EAH-Jena/asuromote/README.md

asuromote
=========

AsureMote - Asuro Remote Control Unit
