EAH-Jena/asuromote/doc/laborbuch/titelseite.tex

\begin{titlepage}
\vspace*{\fill}
\begin{center}
	\textsc{\LARGE Ernst-Abbe-Hochschule Jena} \\ [1.5cm]

	\textsc{\Large Projekt Mikrorechnerentwurf} \\ [0.5cm]

	\HRule \\ [0.3cm]
	{\LARGE AsuroMote}\\	[0.3cm]
	{\Large Entwicklung einer Roboterfernsteuerung }
	\HRule \\ [1 cm]

	\begin{minipage}{0.4\textwidth}
		\begin{flushleft} \large
			\emph{Gruppenmitglieder:}\\
			Stefan \textsc{Biereigel}\\
			Rene \textsc{Winkler}\\
			Mathias \textsc{Fugmann}\\
			Junlong \textsc{Yin}\\
		\end{flushleft}
	\end{minipage}
	\begin{minipage}{0.4\textwidth}
		\begin{flushright} \large
			\emph{Betreuer:}\\
			Burkart \textsc{Voß}\\
		\end{flushright}
	\end{minipage}

\end{center}
\vspace*{\fill}
\end{titlepage}
