EAH-Jena/asuromote/doc/laborbuch/treffen/treffen-2014-11-06.tex

\chapter{Treffen am 6.11.2014}
\section{Anwesende Personen}
\begin{itemize}
	\item Stefan Biereigel
	\item Rene Winkler
	\item Mathias Fugmann
	\item Junlong Yin
\end{itemize}

\section{Besprochen bzw. Bearbeitet}
Dieses Praktikum wurde vollständig für die Kodierung und Verbesserung des SPI-Moduls verwendet. Dieses wird nun für die Ansteuerung des Beschleunigungs-Sensors genutzt.

Mathias und Stefan besprachen einen sinnvollen Weg zur Versionsverwaltung von Dokumentation und Software und einigten sich auf die Verwendung von Git als Source Code Management System. Ein Treffen für eine gemeinsame Einführung in Git wurde auf den 7.11. terminiert.
