EAH-Jena/asuromote/doc/hw-spec/hw-spec.odt

asuroMote

Hardwarespezifikation (Remote Control)

Autor: Stefan Biereigel, Rene Winkler

Stand: 25.04.2015

Gültigkeit: gültig, alle Angaben aber TBC

# Aufgabe dieses Dokuments

Für die Erfüllung aller Kundenanforderungen muss eine Hardware entwickelt werden, die das STM32F4 Discovery mit den angeschlossenen Peripheriebaugruppen verbindet. Auch ein zu erarbeitendes Stromversorgungskonzept muss auf dieser Hardware umgesetzt werden. Dieses Dokument beschreibt alle Hardware-Schnittstellen und die Implementierung aller Features.

# Anforderungen

An die Hardware werden folgende Anforderungen (in loser Folge) gestellt:

- STM32F4 Discovery als Grundlage zur Anbindung von Peripherie
- Anbindung des LC-Displays, Positionierung nach Fertigungszeichnung
- Anbindung des nRF24L01
- Anbindung von 4 Tastern, Positionierung nach Fertigungszeichnung
- Anbindung von einem Joystick, Positionierung nach Fertigungszeichnung
- Anbindung eines 3-Wege-Schiebeschalters nach Fertigungszeichnung
- Anbindung eines Li-Ion/Li-Po-Akkus inklusive Ladeschaltung
  - Bereitstellen des Ladestatus am STM32F4
- Signalisierung des Stromversorgungszustandes durch eine LED
- Integration eines USB-Seriell-Wandlers
- Rücksichtnahme auf Positionierung aller Bauteile
- Verwendung von Gehäusen mit Pitch >= 0,5mm

# Peripherieanbindung an STM32F4

Der STM32F407VG als CPU soll mit allen Hardwareelementen kommunizieren können. In der folgenden Tabelle sind alle anzubindenden Signale mit deren entsprechendem Pin und der optionalen Hardwarefunktionalität aufgeführt.

Funktion | Pin (STM32F407) | Alternate Function | Bemerkung
nRF24L01 CS | PB12 | SPI2_NSS
nRF24L01 CE | PB10 | GPIO | auch MP45DT02 CLK
nRF24L01 SCLK | PB13 | SPI2_SCK
nRF24L01 MOSI | PB15 | SPI2_MOSI
nRF24L01 MISO | PB14 | SPI2_MISO
nRF24L01 IRQ | PB11 | GPIO
LCD RESET | PA8 | GPIO
LCD RS | PA10 | GPIO | USB ID
LCD CS | PA15 | SPI3_NSS
LCD SCLK | PC10 | SPI3_SCK | auch CS43L22 CLK
LCD MOSI/MISO | PC12 | SPI3_MOSI | auch CS43L22 SDIN
USB-UART TX | PA1 | USART4_RX
USB-UART RX | PA0 | USART4_TX | auch USER-Button
Taster „Rechts“ | PE8 | GPIO | T1
Taster „Runter“ | PE10 | GPIO | T2
Taster „Links“ | PE12 | GPIO | T3
Taster „Hoch“ | PE14 | GPIO | T4
Joystick „X“ | PC1 | ADC123_IN11
Joystick „Y“ | PC2 | ADC123_IN12
Power-Supply-Enable | x | x | Nur zur SMPS
Accelerometer Enable | PC6 | GPIO | Vom Schalter, low active
Charging Active | PA3 | GPIO | low active

# Steckverbinder-Spezifikation

Zur Verbindung der drei Leiterplatten werden zwei Steckverbinder eingesetzt. Diese sind als 2,54mm-Raster-Stiftleisten ausgeführt. Auf dem Mainboard sind wegen anliegender Spannungen (Kurzschlussgefahr) Buchsenleisten angebracht, die Sfiftleisten auf den angeschlossenen Leiterplatten.

# | Signal | Bemerkung

1 | 3V | kommend von STM32F4 Discovery
2 | JOY_X | X-Achse Joystick, an ADC angebunden
3 | JOY_Y | Y-Achse Joystick, an ADC angebunden
4 | GND

# | Signal | Bemerkung

1 | GND
2 | ACC_EN | Low-Aktiv, Aktivierung des Beschleunigungssensors
3 | PS_SHDN | High-Aktiv, Abschaltung der Stromversorgung
4 | T1 | Taste „Rechts“
5 | T2 | Taste „Runter“
6 | T3 | Taste „Links“
7 | T4 | Taste „Hoch“
