EAH-Jena/asuromote/doc/laborbuch/anhang.tex

\chapter{Anhang}

\begin{figure}
	\centering
	
	\caption{Konzept-Übersicht}
	\label{fig:konzepte1}
\end{figure}

% Konzepte, erste Version
\begin{figure}
	\centering
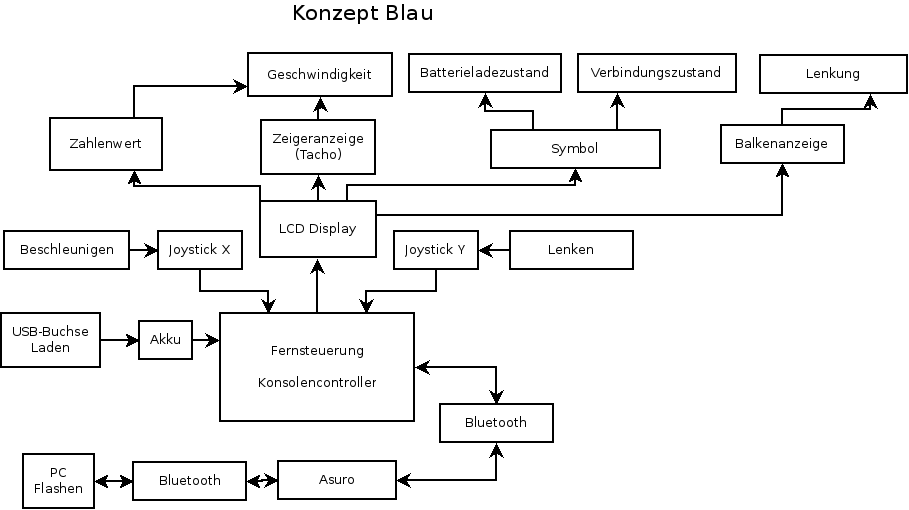
[picture p2: doc/laborbuch/konzepte_v1/Konzept_Blau.png]
	
	\label{fig:blau_v1}
	\caption{Konzept Blau, Version 1}
\end{figure}

\begin{figure}
	\centering
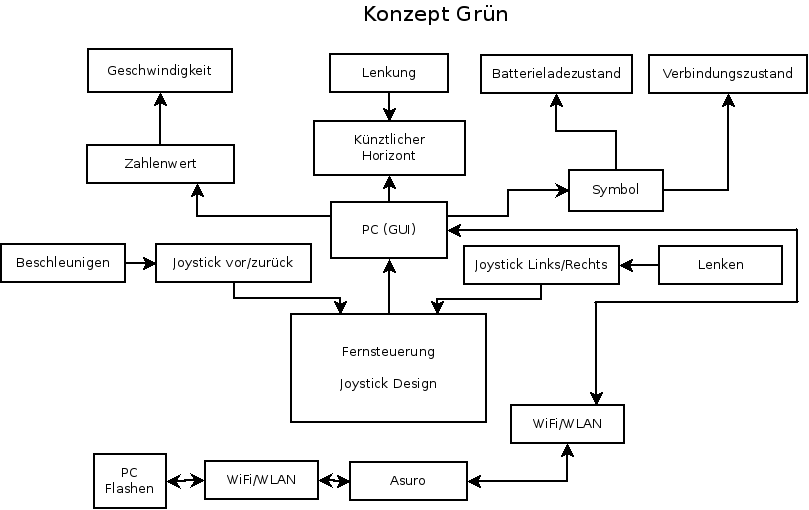
[picture p3: doc/laborbuch/konzepte_v1/Konzept_Gruen.png]
	
	\caption{Konzept Grün, Version 1}
	\label{fig:gruen_v1}
\end{figure}

\begin{figure}
	\centering
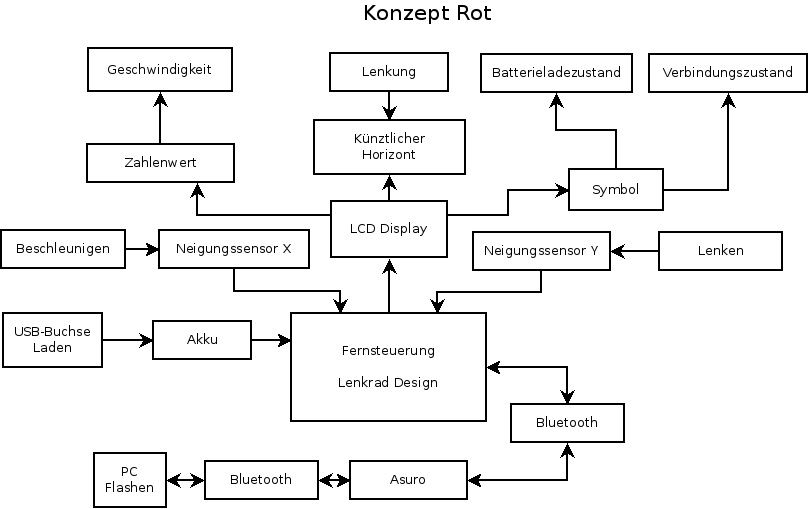
[picture p4: doc/laborbuch/konzepte_v1/Konzept_Rot.png]
	
	\caption{Konzept Rot, Version 1}
	\label{fig:rot_v1}
\end{figure}

% Konzepte, zweite Version
\begin{figure}
	\centering
	
	\caption{Konzept-Übersicht, Version 2}
	\label{fig:konzepte2}
\end{figure}

\begin{figure}
	\centering
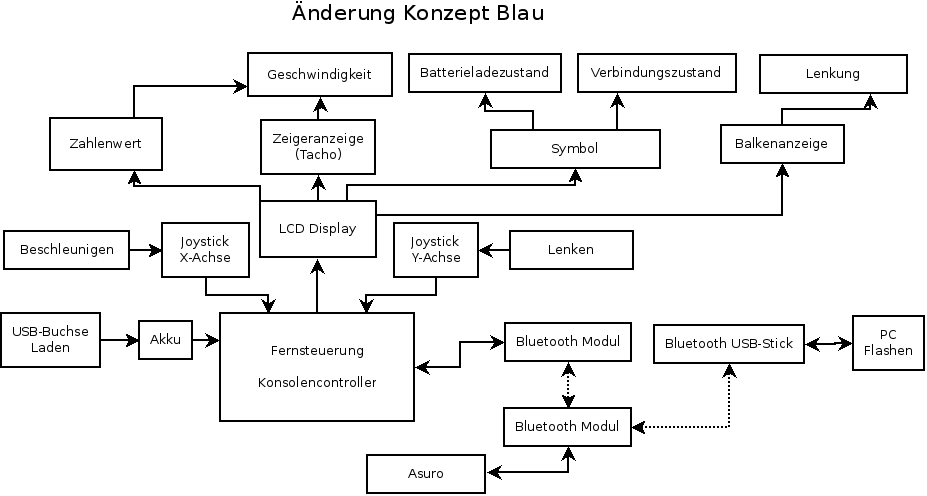
[picture p5: doc/laborbuch/konzepte_v2/Konzept_Blau.png]
	
	\caption{Konzept Blau, Version 2}
	\label{fig:blau_v2}
\end{figure}

\begin{figure}
	\centering
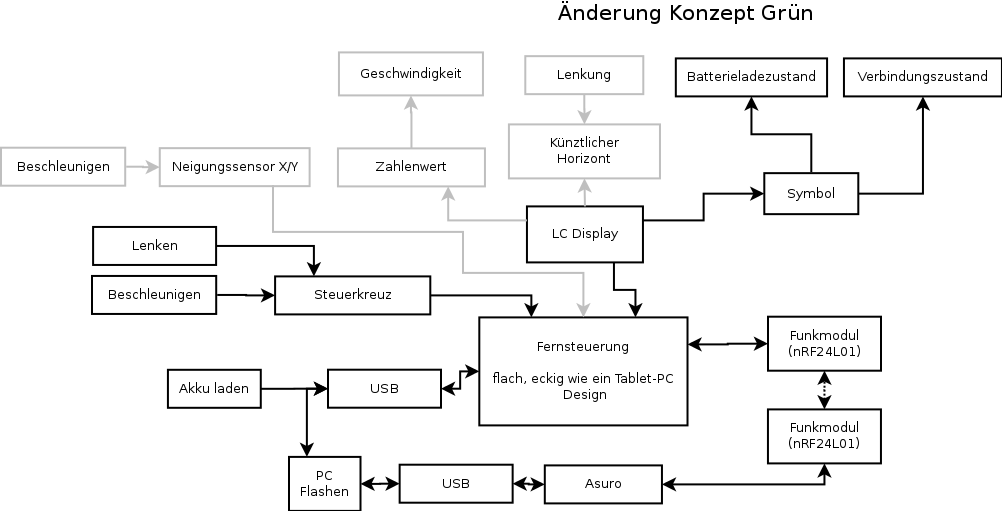
[picture p6: doc/laborbuch/konzepte_v2/Konzept_Gruen.png]
	
	\caption{Konzept Grün, Version 2}
	\label{fig:gruen_v2}
\end{figure}

\begin{figure}
	\centering
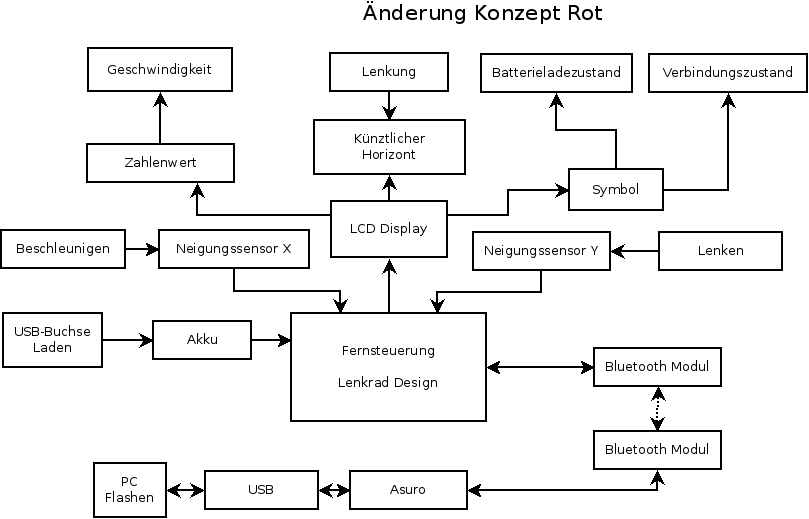
[picture p7: doc/laborbuch/konzepte_v2/Konzept_Rot.png]
	
	\caption{Konzept Rot, Version 2}
	\label{fig:rot_v2}
\end{figure}
