EAH-Jena/asuromote/doc/laborbuch/treffen/treffen-2015-03-26.tex

\chapter{Treffen am 26.03.2014}
\section{Anwesende Personen}
\begin{itemize}
	\item Stefan Biereigel
	\item Rene Winkler
\end{itemize}

\section{Besprochen bzw. Bearbeitet}
Als Grundlage für das Softwarekonzept wurde das Bedienkonzept ausgearbeitet. Es wurden die für den User sichtbaren Bildschirme (Screens) als Mock-Up gezeichnet und davon notwendige Softwarekomponenten ("Programme") abgeleitet. 

\textbf{TODO Grafik einfügen aus Block}.

Von diesen ausgehend wurde ein Übergangsdiagramm erstellt, wie zwischen den einzelnen Programmen umgeschaltet wird. 

\textbf{TODO Grafik einfügen aus Block}.

Diese "Programme" und die von ihnen benötigten Informationen wurden benutzt, um die Schnittstellen zu Hardware-Treibern zu definieren. 
Außerdem wurde mit der Konzeption eines Protokolles für das nRF-Funkmodul begonnen. Als Heimarbeit wurde sich aufgegeben, die notwendigen Softwaremodule gedanklich durchzuplanen, um beim nächsten mal eine Software-Spezifikation für die unteren Schichten zu erstellen.
