EAH-Jena/asuromote/doc/laborbuch/treffen/treffen-2015-04-08.tex

\chapter{Treffen am 08.04.2014}
\section{Anwesende Personen}
\begin{itemize}
	\item Stefan Biereigel
	\item Rene Winkler
\end{itemize}

\section{Besprochen bzw. Bearbeitet}
Die Software-Modulbeschreibung wurde fertiggestellt, die Änderungen schlagen sich im Dokument \textit{Spezifikation Software} nieder. Als Aufgabe für die kommende Woche wurde die Vorbereitung auf das Design-Review gestellt, bei dem alle Aspekte des Gerätes vorgestellt werden sollen.
