EAH-Jena/asuromote/doc/laborbuch/treffen/treffen-2015-04-15.tex

\chapter{Treffen am 15.04.2014}
\section{Anwesende Personen}
\begin{itemize}
	\item Stefan Biereigel
	\item Rene Winkler
\end{itemize}

\section{Besprochen bzw. Bearbeitet}
Die Vorbereitung auf das anstehende Design-Review wurde fortgesetzt und eine Aufteilung der Redeteile vorgenommen. Jeder beschäftigte sich daraufhin mit der Zusammenstellung seiner Redebeiträge. Rene arbeitete außerdem am Gehäuse weiter und es wurde über die Realisierung der Rückhol-Vorrichtung für die Taster diskutiert. Kommende Woche liegt das Design-Review an, bei dem das Produkt vorgestellt werden soll.
