EAH-Jena/asuromote/doc/laborbuch/treffen/treffen-2014-11-07.tex

\chapter{Treffen am 7.11.2014}
\section{Anwesende Personen}
\begin{itemize}
	\item Stefan Biereigel
	\item Rene Winkler
	\item Mathias Fugmann
	\item Johannes Backhaus
\end{itemize}

\section{Besprochen bzw. Bearbeitet}
Wie am Tag zuvor vereinbart wurde ein zweistündiges Treffen zur Einführung von Git in den Entwicklungsprozess durchgeführt. Die Grundlagen von git wurden von Stefan Biereigel zuerst auf der Kommandozeile gezeigt und währenddessen direkt von den anderen Anwesenden ausprobiert. Im Anschluss daran wurde die Bedienung mit verschiedenen GUIs für Git probiert und der Umgang mit Repositories auf Github ausprobiert. Themen enthielten unter anderem sinnvolle Beschreibung von Commits und das Lösen von entstandenen Konflikten.
