EAH-Jena/asuromote/doc/laborbuch/treffen/treffen-2014-11-10.tex

\chapter{Treffen am 10.11.2014}
\section{Anwesende Personen}
\begin{itemize}
	\item Stefan Biereigel
	\item Rene Winkler
	\item Mathias Fugmann
	\item Junlong Yin
\end{itemize}

\section{Besprochen bzw. Bearbeitet}
In diesem Seminar gab uns Prof. Voß eine Einführung in den AD-Wandler im STM32F4. Hinterher wurde damit begonnen, den AD-Wandler selbstständig in Software anzusprechen. Rene kümmerte sich weiter um die Realisierung der Programmierung einer "Wasserwaage" als Test für die korrekte Implementierung der Ansteuerung des Beschleunigungssensors.
