EAH-Jena/asuromote/doc/laborbuch/bilder/screens.png

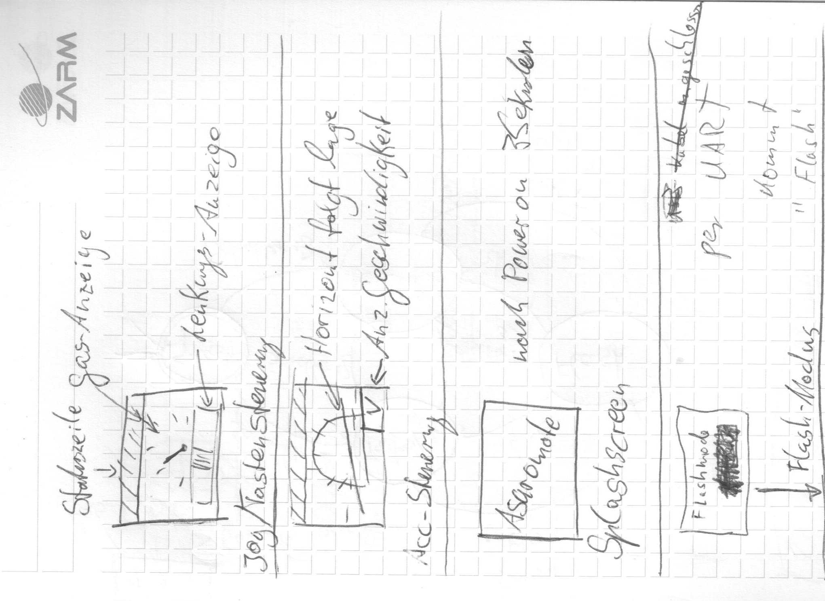
doc/laborbuch/bilder/screens.png
