EAH-Jena/asuromote/doc/laborbuch/bilder/states.png

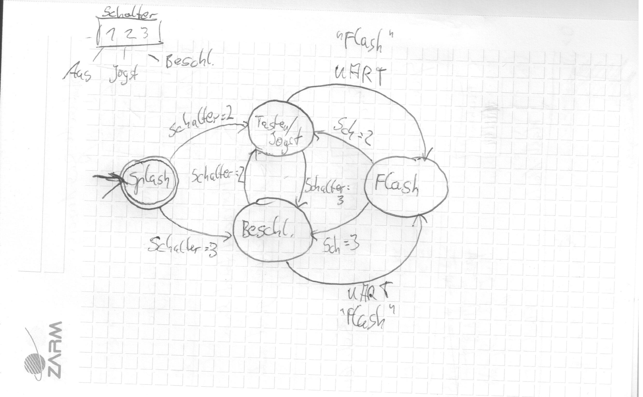
doc/laborbuch/bilder/states.png
