EAH-Jena/asuromote/doc/laborbuch/bilder/zeitplan.png

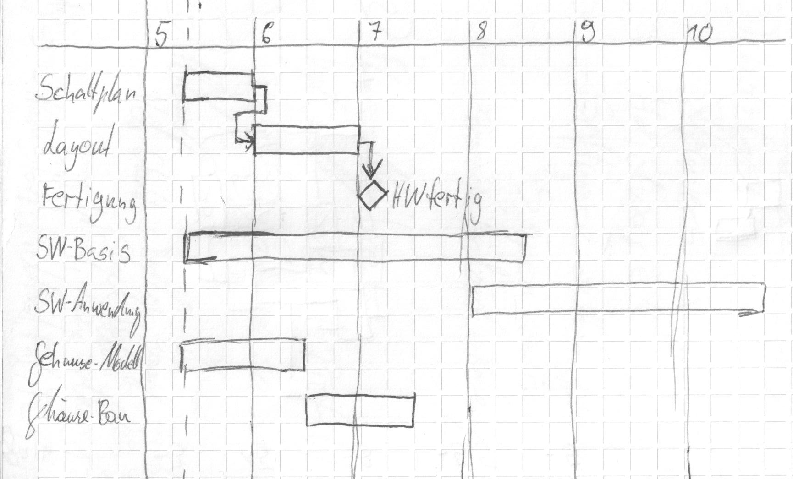
doc/laborbuch/bilder/zeitplan.png
