EAH-Jena/asuromote/doc/laborbuch/konzepte_dia/Konzept Final.png

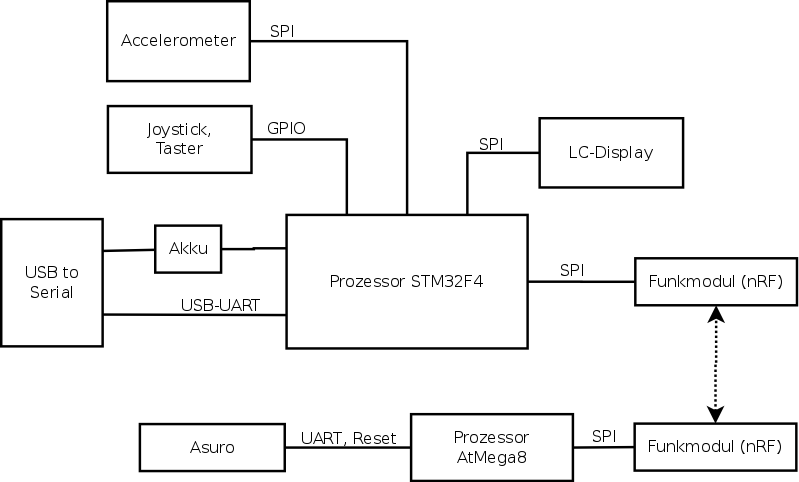
doc/laborbuch/konzepte_dia/Konzept Final.png
