EAH-Jena/asuromote/doc/laborbuch/konzepte_v2/Konzepte.pdf

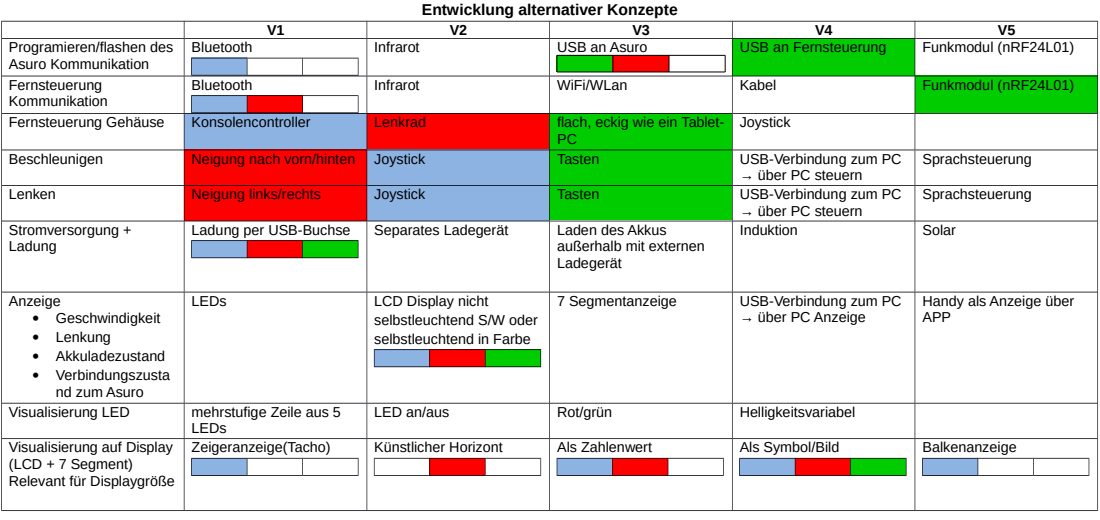
[picture p14: page 1]
Bluetooth; Infrarot; USB an Asuro; USB an Fernsteuerung; Funkmodul (nRF24L01); WiFi/WLan; Kabel; Fernsteuerung Gehäuse; Konsolencontroller; Lenkrad; flach, eckig wie ein Tablet-; Joystick; Beschleunigen; Neigung nach vorn/hinten; Tasten; USB-Verbindung zum PC; Sprachsteuerung; Lenken; Neigung links/rechts; Stromversorgung + Ladung; Ladung per USB-Buchse; Separates Ladegerät; Laden des Akkus; Induktion; Solar; Anzeige • Geschwindigkeit • Lenkung • Akkuladezustand • Verbindungszusta nd zum Asuro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

Entwicklung alternativer Konzepte

Programieren/flashen des
Asuro Kommunikation
Fernsteuerung
Kommunikation

→ über PC steuern

außerhalb mit externen Ladegerät

LEDs | LCD Display nicht selbstleuchtend S/W oder selbstleuchtend in Farbe

Handy als Anzeige über
APP

→ über PC Anzeige

Visualisierung auf Display
(LCD + 7 Segment)
Relevant für Displaygröße
