EAH-Jena/asuromote/src/UART/main.c

#include "stm32f4_discovery.h"
#include "stm32f4xx_conf.h"
#include <stm32f4xx.h>
#include <stm32f4xx_usart.h>

#include "uart.h"

GPIO_InitTypeDef  GPIO_InitStructure;

void Delay(__IO uint32_t nCount);

int main(void)
{
	/* GPIOD Periph clock enable */
	RCC_AHB1PeriphClockCmd(RCC_AHB1Periph_GPIOD, ENABLE);

	/* Configure PD12, PD13, PD14 and PD15 in output pushpull mode */
	GPIO_InitStructure.GPIO_Pin = GPIO_Pin_12 | GPIO_Pin_13| GPIO_Pin_14| GPIO_Pin_15;
	GPIO_InitStructure.GPIO_Mode = GPIO_Mode_OUT;
	GPIO_InitStructure.GPIO_OType = GPIO_OType_PP;
	GPIO_InitStructure.GPIO_Speed = GPIO_Speed_100MHz;
	GPIO_InitStructure.GPIO_PuPd = GPIO_PuPd_NOPULL;
	GPIO_Init(GPIOD, &GPIO_InitStructure);

	USART1_init(115200);
	while (1)
	{
		USART_puts(USART1, "STM32F4 USART Test\r\n.");
		GPIO_SetBits(GPIOD, GPIO_Pin_12);
		Delay(0xFFFFFF);
		GPIO_ResetBits(GPIOD, GPIO_Pin_12|GPIO_Pin_13|GPIO_Pin_14|GPIO_Pin_15);
		Delay(0xFFFFFF);

	}

}

void Delay(__IO uint32_t nCount)
{
while(nCount--) {  }
}

#ifdef  USE_FULL_ASSERT

void assert_failed(uint8_t* file, uint32_t line)
{
	/* Infinite loop */
	while (1) {}
}
#endif
