EAH-Jena/asuromote/src/UART/uart.c

/*
 * UART library
 *
 * source: https://github.com/devthrash/STM32F4-examples/blob/master/USART/main.c
 */

#include "stm32f4_discovery.h"
#include "stm32f4xx_conf.h"
#include <stm32f4xx.h>
#include <stm32f4xx_usart.h>
#include <inttypes.h>

void USART1_init(uint32_t baudrate) {
	USART_InitTypeDef USART_InitStruct;
	GPIO_InitTypeDef GPIO_InitStruct;
	NVIC_InitTypeDef NVIC_InitStructure;

	RCC_APB2PeriphClockCmd(RCC_APB2Periph_USART1, ENABLE);
	RCC_AHB1PeriphClockCmd(RCC_AHB1Periph_GPIOB, ENABLE);

	GPIO_InitStruct.GPIO_Pin = GPIO_Pin_6 | GPIO_Pin_7;
	GPIO_InitStruct.GPIO_Mode = GPIO_Mode_AF;
	GPIO_InitStruct.GPIO_Speed = GPIO_Speed_50MHz;
	GPIO_InitStruct.GPIO_OType = GPIO_OType_PP;
	GPIO_InitStruct.GPIO_PuPd = GPIO_PuPd_NOPULL;
	GPIO_Init(GPIOB, &GPIO_InitStruct);

	GPIO_PinAFConfig(GPIOB, GPIO_PinSource6, GPIO_AF_USART1);
	GPIO_PinAFConfig(GPIOB, GPIO_PinSource7, GPIO_AF_USART1);

	USART_InitStruct.USART_BaudRate = baudrate;
	USART_InitStruct.USART_WordLength = USART_WordLength_8b;
	USART_InitStruct.USART_StopBits = USART_StopBits_1;
	USART_InitStruct.USART_Parity = USART_Parity_No;
	USART_InitStruct.USART_HardwareFlowControl = USART_HardwareFlowControl_None;
	USART_InitStruct.USART_Mode = USART_Mode_Tx | USART_Mode_Rx;
	USART_Init(USART1, &USART_InitStruct);

	USART_ITConfig(USART1, USART_IT_RXNE, ENABLE);

	NVIC_InitStructure.NVIC_IRQChannel = USART1_IRQn;
	NVIC_InitStructure.NVIC_IRQChannelPreemptionPriority = 0;
	NVIC_InitStructure.NVIC_IRQChannelSubPriority = 0;
	NVIC_InitStructure.NVIC_IRQChannelCmd = ENABLE;
	NVIC_Init(&NVIC_InitStructure);
	USART_Cmd(USART1, ENABLE);
}

void USART_puts(USART_TypeDef* USARTx, volatile char *s) {
	while(*s) {
		while( !(USARTx->SR & 0x00000040) );
		USART_SendData(USARTx, *s);
		*s++;
	}
}

void USART1_IRQHandler(void) {
	if( USART_GetITStatus(USART1, USART_IT_RXNE) ){
		static uint8_t cnt = 0;
		char t = USART1->DR;
		/* put t into our RX fifo here .. */
	}
}
