EAH-Jena/asuromote/(commit log)

2014-12-01 MEM Init eingebaut, SPI init umgebaut
    MEM Init eingebaut, SPI init umgebaut.
    Interrupt gesteuert fehlt noch.
2014-12-04 Basicfunktionen in separate Dateien ausgelagert
    in separate Dateien ausgelagert damit es später besser kombiniert werden
    kann und übersichtlich bleibt
2014-12-06 UART working example
2014-12-08 Pin Belegung vom Funkmodul zum STM32f4
    Die erste Version der Pin Belegung
2014-12-09 Funkmodul
    Pin_set.txt vervollständigt
    Bibliotheken des Funkmoduls hinzugefügt: tm_stm32f4_nrf24l01.*
    Bibliotheken für SPI Kommunikation hinzugefügt: tm_stm32f4_spi.*
    für die Anpassbarkeit der Funkmodulbibliothek an Renes SPI
    Kommunikation.
